BaudouinBelpaire/Human_Eye_Mechanism/CAD/Human_Eye_System_Assembly.step

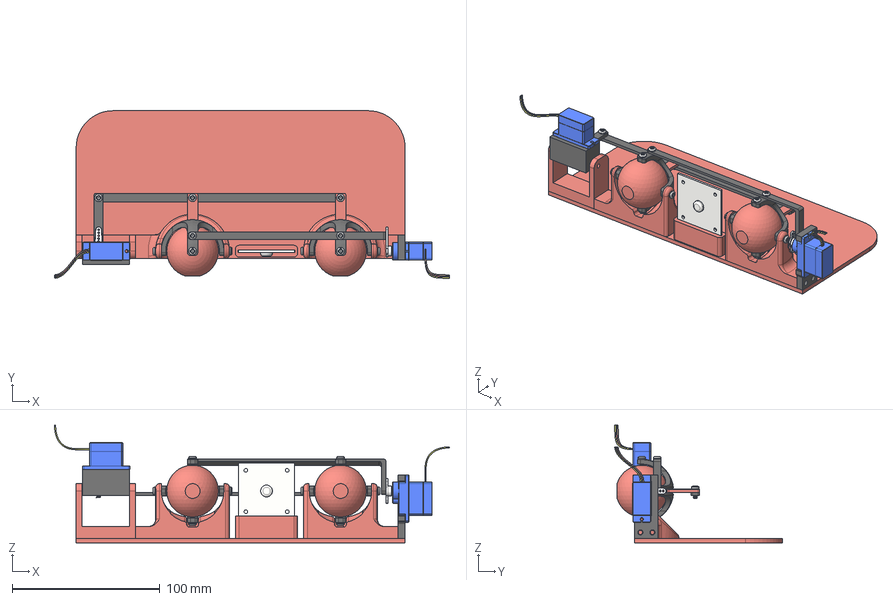
[picture p31: CAD file, 2024-05-09]
CAD/Human_Eye_System_Assembly.step
267.2 x 113.4 x 79.5 mm
Servo_holder_Y_axis
Eye_link x 2
Base_V2
Eye x 2
M3x6 Philips Screw x 13
Base_Left_V3
System_base
Servo_arm_link
Motor_holder
Servo_cradle_X_axis
Crank
Servo_2 x 2
PernoServo x 2
LevaServo x 2
Link_X_axis
USB_camera
